ryan-james-thomas/digital-current-controller-circuit/Generated/Digital_Current_Servo_v3.pdf

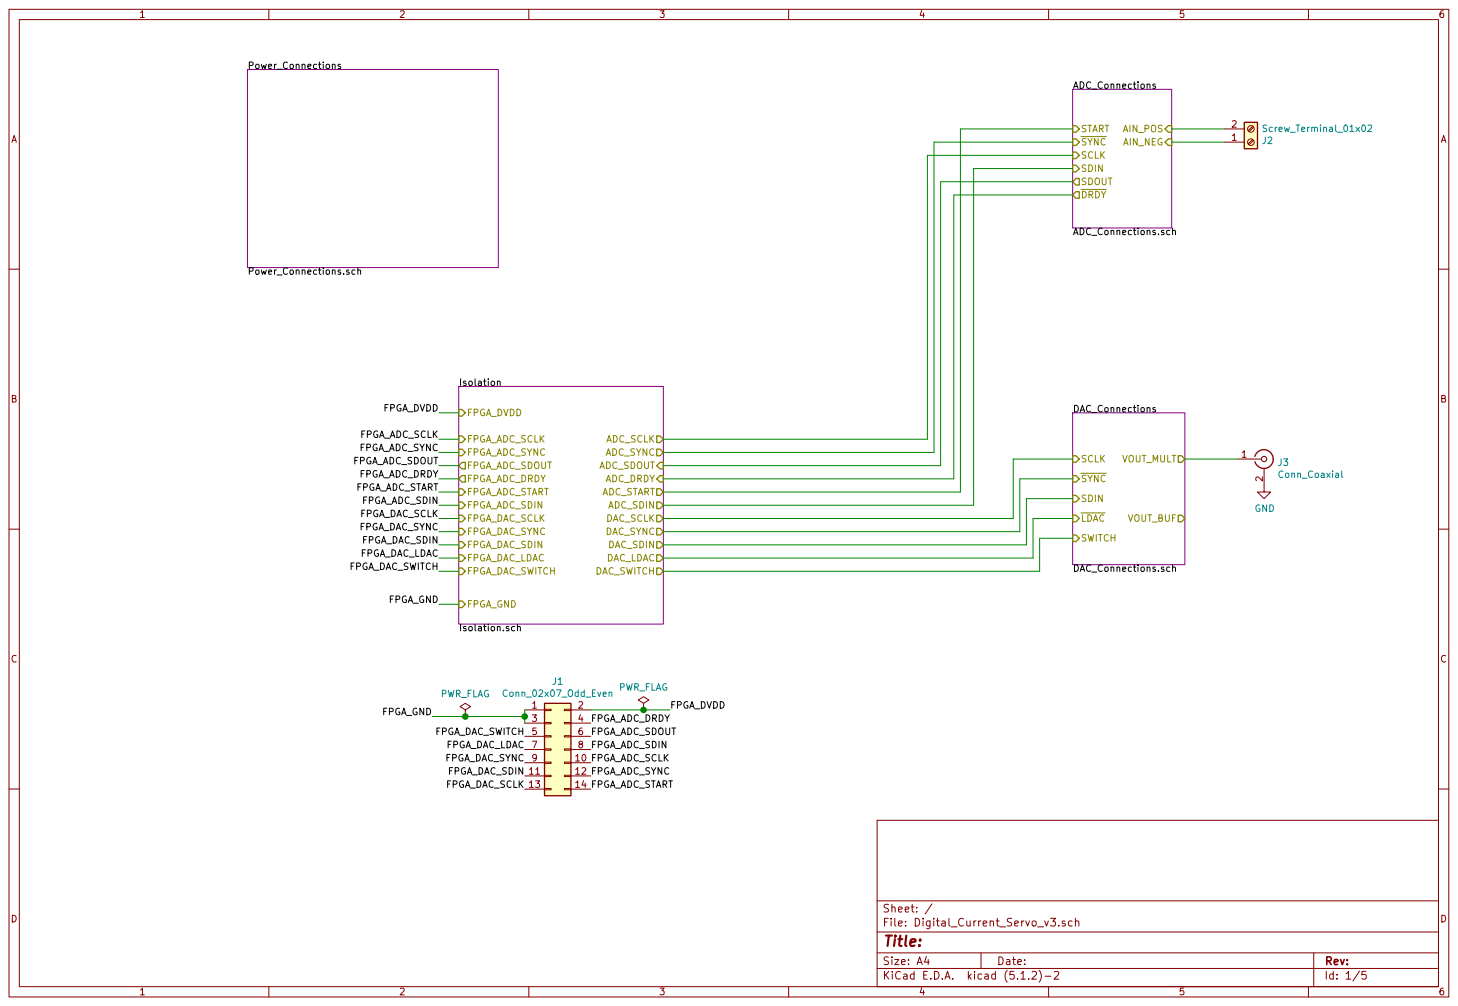
[picture p1: page 1]

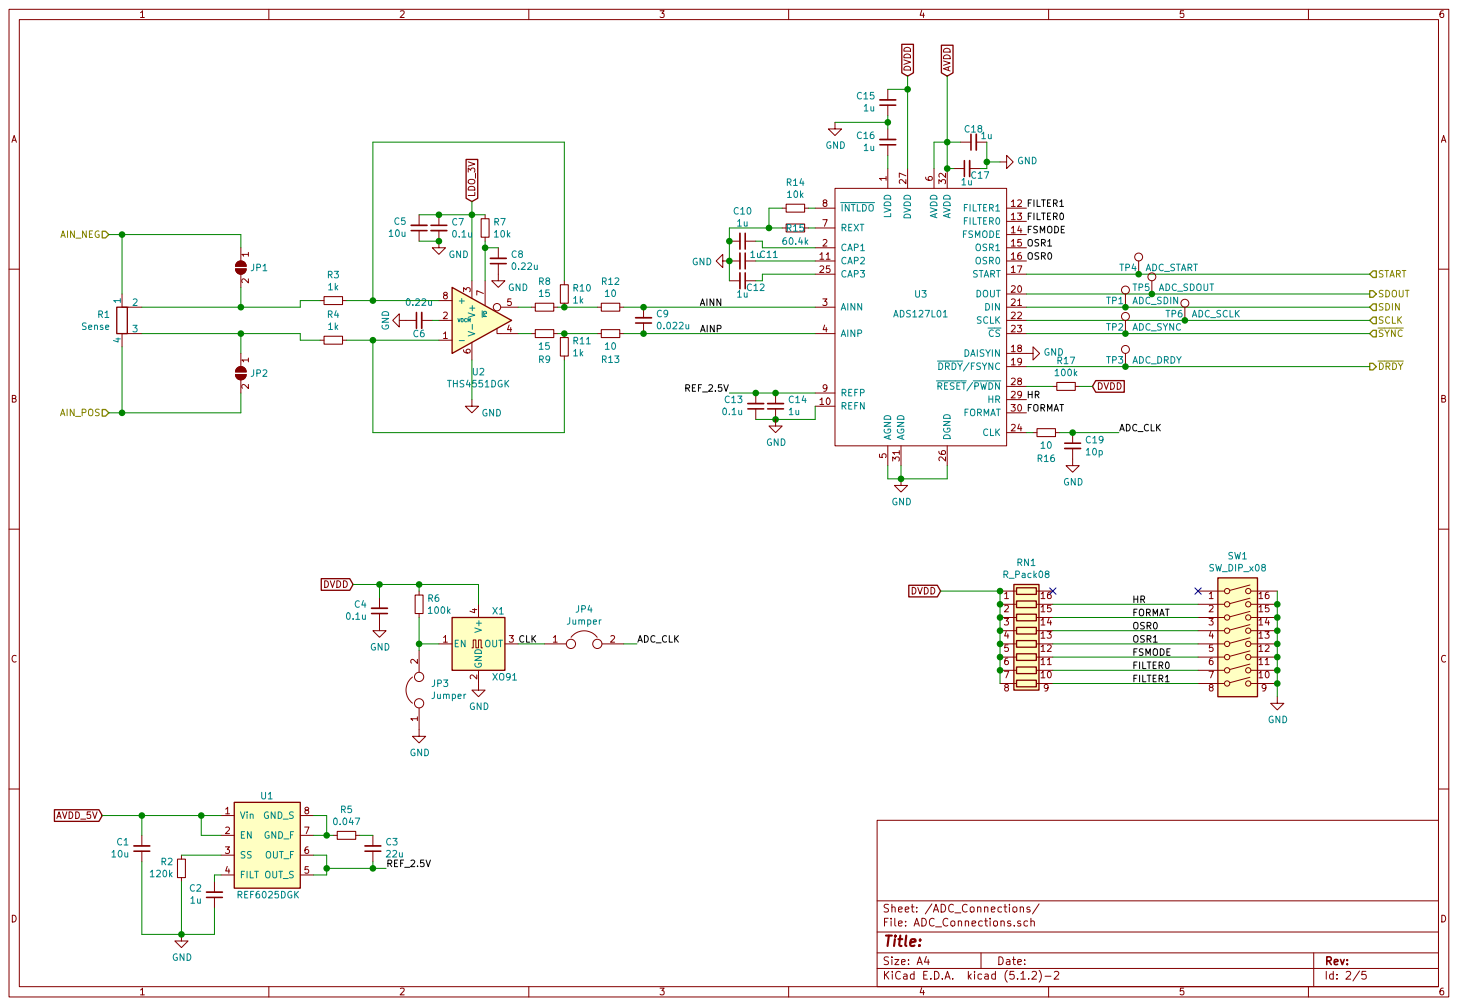
[picture p2: page 2]

1 REFN 10 CAP2 11 FILTER1 12 FILTER0 13 FSMODE 14 OSR1 15 OSR0 16 START 17 DAISYIN 18 DRDY/FSYNC 19 CAP1 2 DOUT 20 DIN 21 SCLK 22 CS 23 CLK 24 CAP3 25 DGND 26 DVDD 27 RESET/PWDN 28 HR 29 AINN 3 FORMAT 30 AGND 31 AVDD 32 AINP 4 AGND

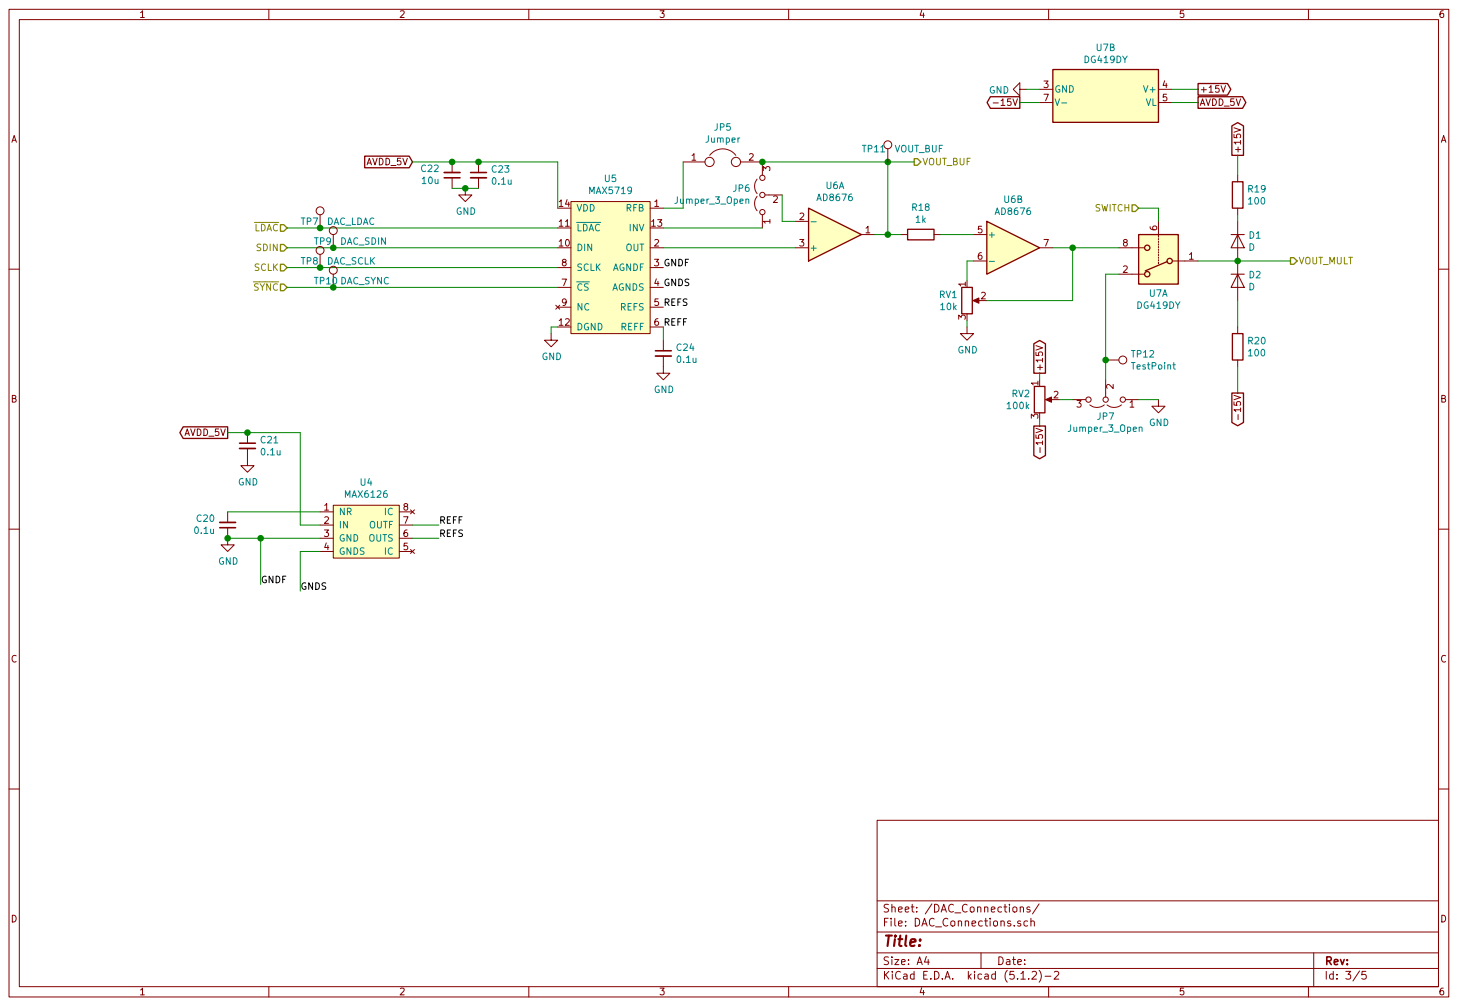
[picture p3: page 3]

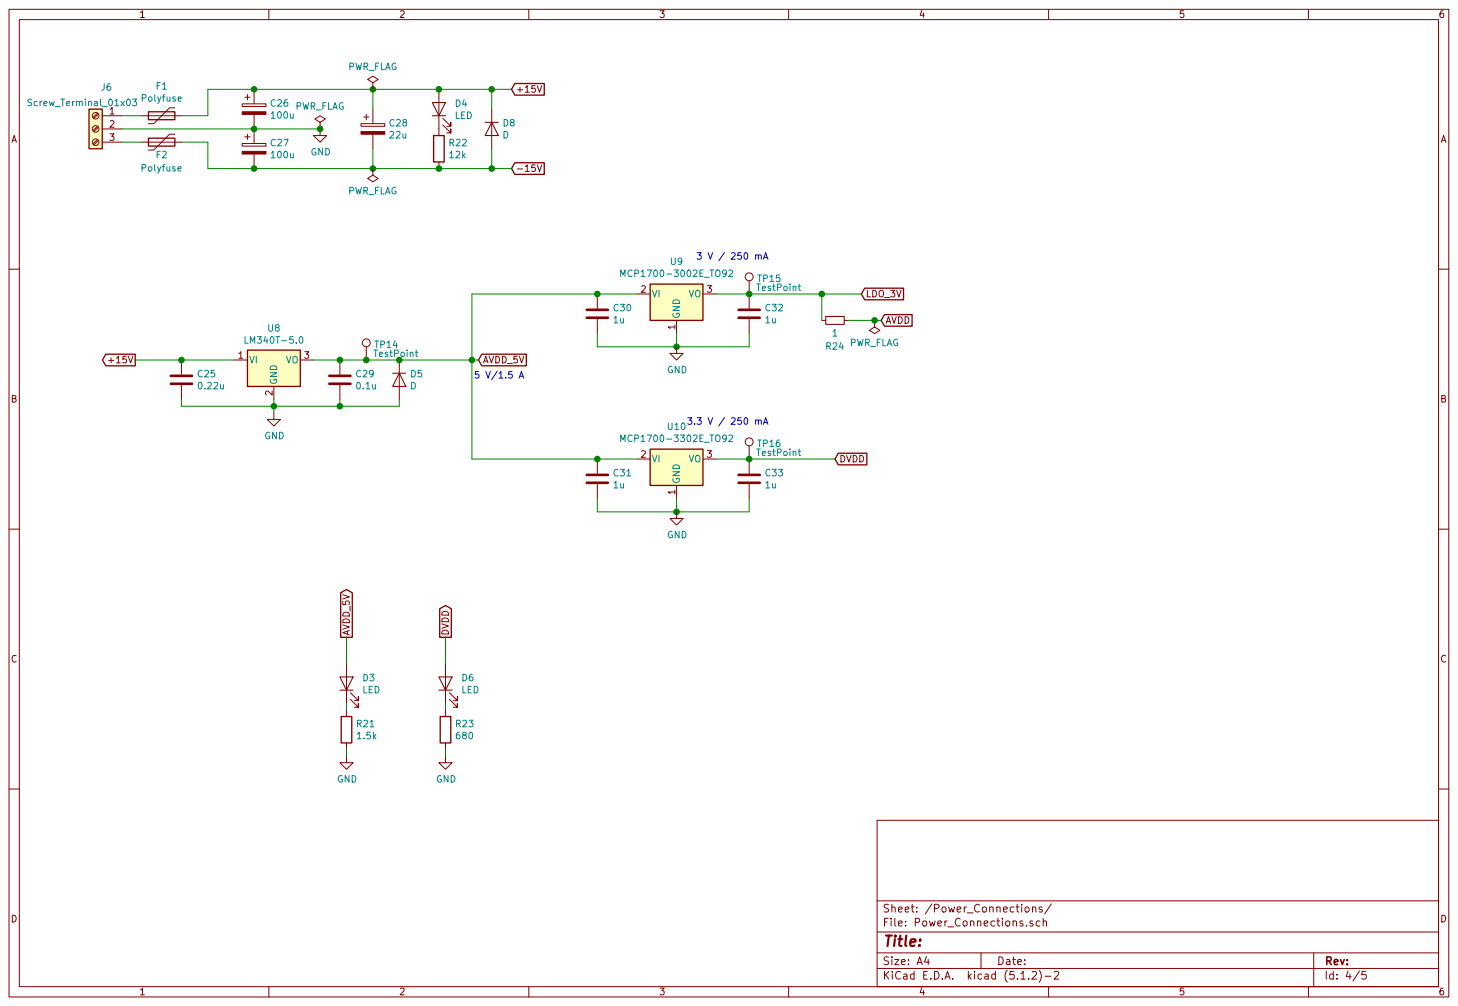
[picture p4: page 4]

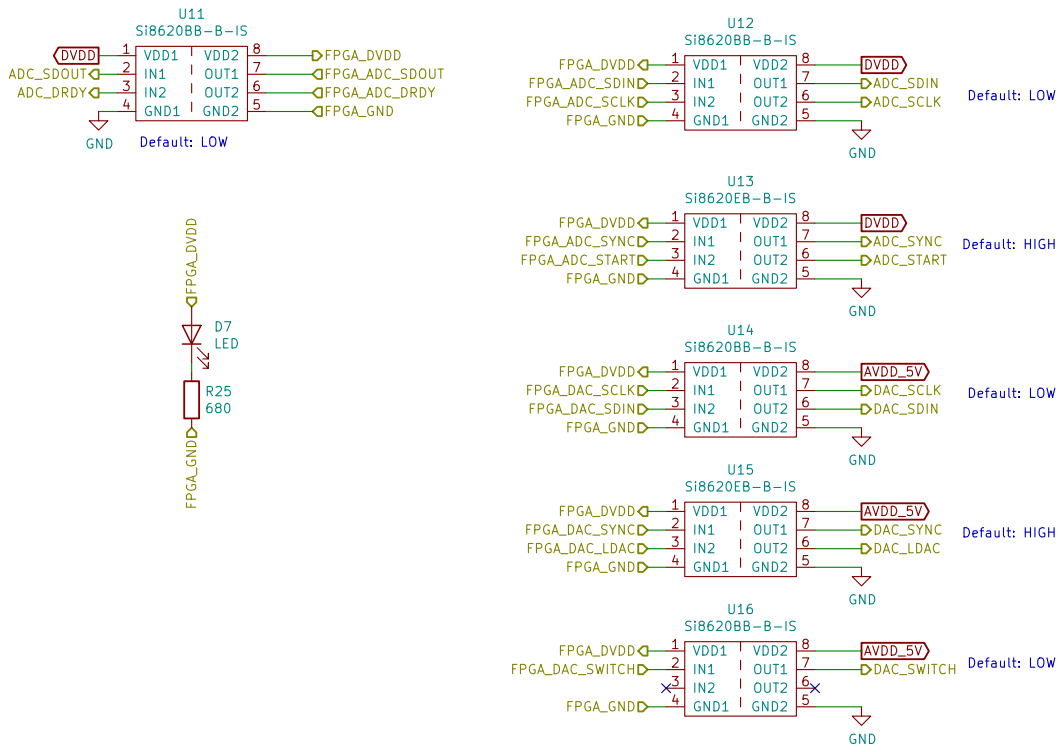
[picture p5: page 5]

Id: 5/5 Title: File: Isolation.sch Sheet: /Isolation/
