ryan-james-thomas/digital-current-controller-circuit/Digital_Current_Servo_v3.kicad_pcb

## KiCad design Digital_Current_Servo_v3.kicad_pcb (2023-01-15)

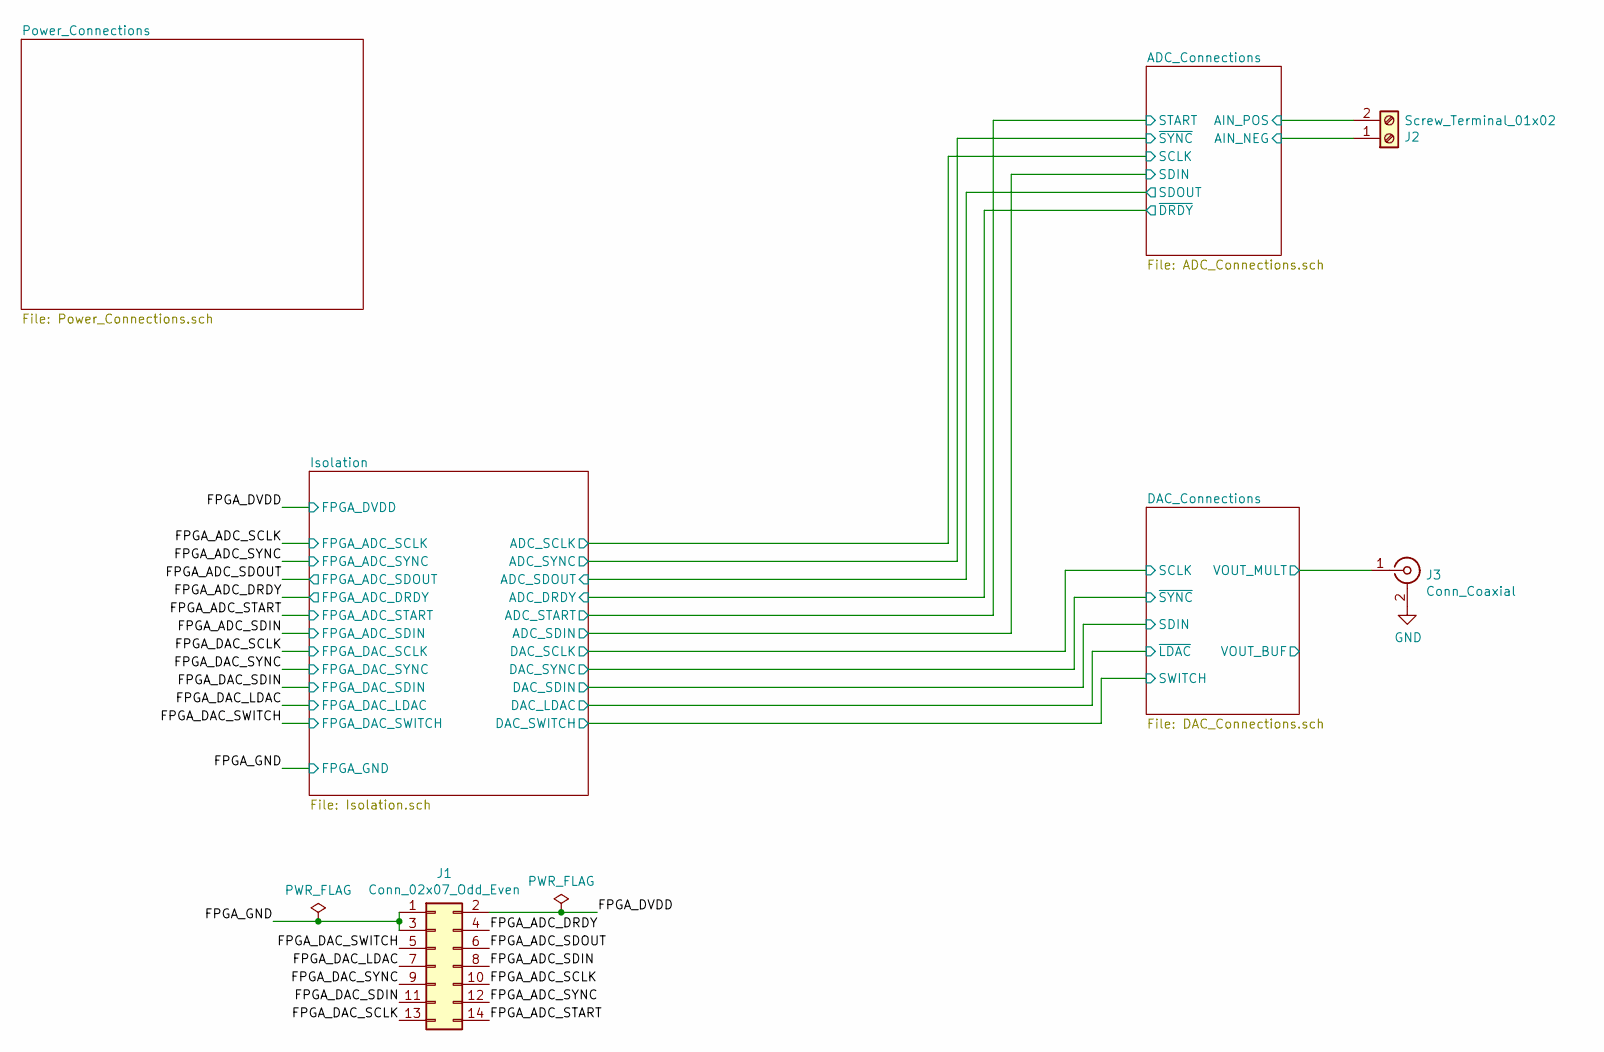
[picture p6: schematic Digital_Current_Servo_v3.sch]

Parts:
J1: Conn_02x07_Odd_Even; PinHeader_2x07_P2.54mm_Vertical; Digikey Part Number S2012EC-07-ND
J2: Screw_Terminal_01x02; TerminalBlock_bornier-2_P5.08mm; Digikey Part Number 732-10955-ND
J3: Conn_Coaxial; BNC_Amphenol_B6252HB-NPP3G-50_Horizontal; Digikey Part Number WM5514-ND

Connections:
/ADC_Connections/AIN_NEG: J2.1; also elsewhere on the board
/ADC_Connections/AIN_POS: J2.2; also elsewhere on the board
/DAC_Connections/VOUT_MULT: J3.1 (In); also elsewhere on the board
/FPGA_ADC_DRDY: J1.4; also elsewhere on the board
/FPGA_ADC_SCLK: J1.10; also elsewhere on the board
/FPGA_ADC_SDIN: J1.8; also elsewhere on the board
/FPGA_ADC_SDOUT: J1.6; also elsewhere on the board
/FPGA_ADC_START: J1.14; also elsewhere on the board
/FPGA_ADC_SYNC: J1.12; also elsewhere on the board
/FPGA_DAC_LDAC: J1.7; also elsewhere on the board
/FPGA_DAC_SCLK: J1.13; also elsewhere on the board
/FPGA_DAC_SDIN: J1.11; also elsewhere on the board
/FPGA_DAC_SWITCH: J1.5; also elsewhere on the board
/FPGA_DAC_SYNC: J1.9; also elsewhere on the board
/FPGA_DVDD: J1.2; also elsewhere on the board
/FPGA_GND: J1.1, J1.3; also elsewhere on the board
GND: J3.2 (Ext); also elsewhere on the board

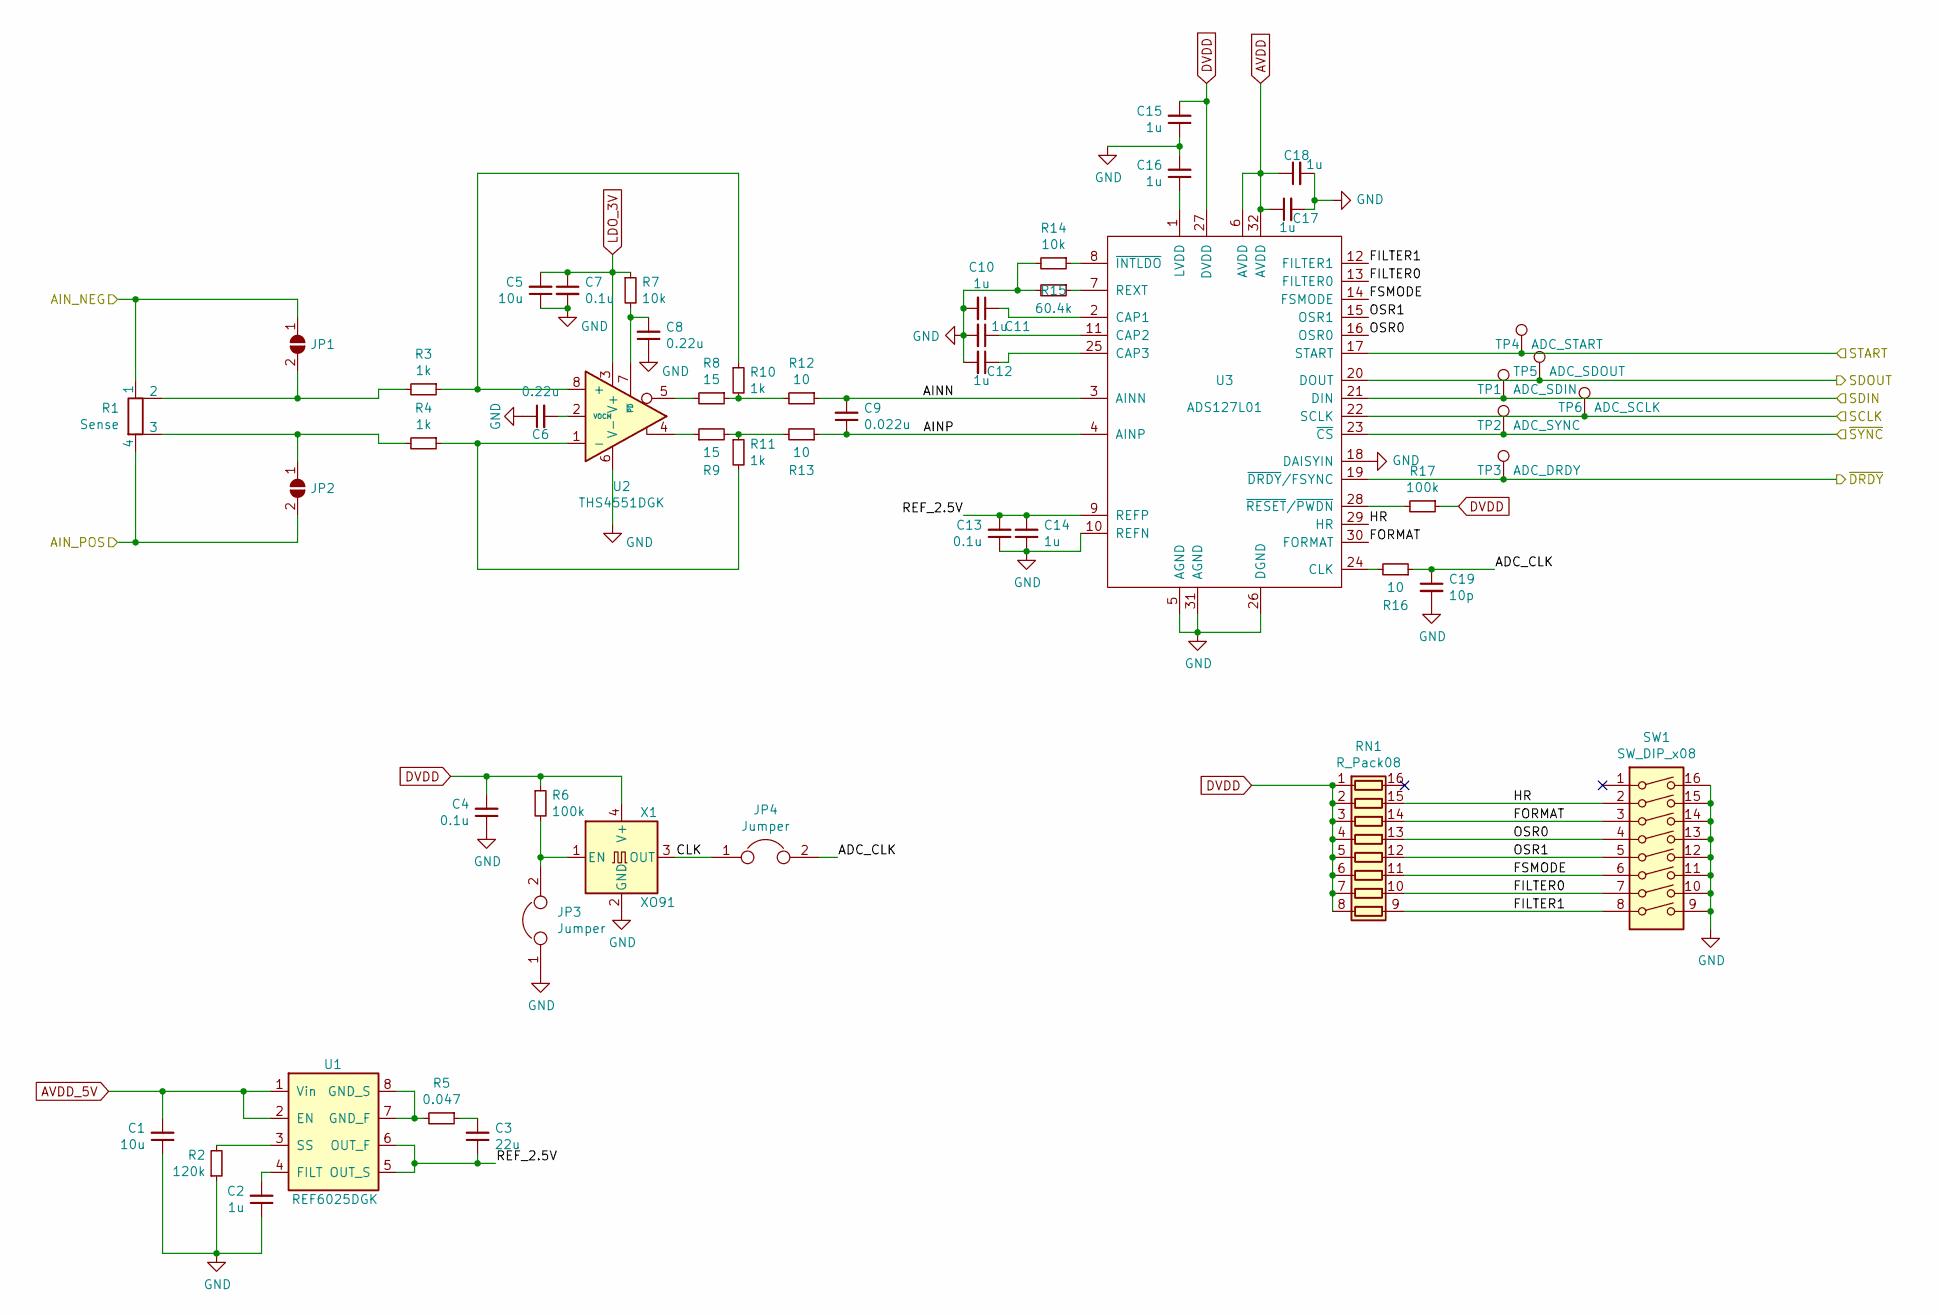
[picture p7: schematic ADC_Connections.sch]

Parts:
C1, C5: 10u; C_0805_2012Metric_Pad1.15x1.40mm_HandSolder; Digikey Part Number 1276-1052-1-ND
C2, C10, C11, C12, C14, C15, C16, C17, C18: 1u; C_0805_2012Metric_Pad1.15x1.40mm_HandSolder; Digikey Part Number 1276-6471-1-ND
C3: 22u; C_1206_3216Metric_Pad1.42x1.75mm_HandSolder; Digikey Part Number 1276-1771-1-ND
C4, C7, C13: 0.1u; C_0805_2012Metric_Pad1.15x1.40mm_HandSolder; Digikey Part Number 1276-1003-1-ND
C6, C8: 0.22u; C_0805_2012Metric_Pad1.15x1.40mm_HandSolder; Digikey Part Number 1276-6478-1-ND
C9: 0.022u; C_0805_2012Metric_Pad1.15x1.40mm_HandSolder; Digikey Part Number 399-1163-1-ND
C19: 10p; C_0805_2012Metric_Pad1.15x1.40mm_HandSolder; Digikey Part Number 1276-1109-1-ND
JP1, JP2: SolderJumper_2_Open; SolderJumper-2_P1.3mm_Open_Pad1.0x1.5mm
JP3, JP4: Jumper; PinHeader_1x02_P2.54mm_Vertical; Digikey Part Number S1012EC-02-ND
R1: Sense; TO-220-4_Vertical; Digikey Part Number Y1690-10A-ND
R2: 120k; R_0805_2012Metric_Pad1.15x1.40mm_HandSolder; Digikey Part Number RR12P120KDCT-ND
R3, R4, R10, R11: 1k; R_0805_2012Metric_Pad1.15x1.40mm_HandSolder; Digikey Part Number P1.0KDACT-ND
R5: 0.047; R_0805_2012Metric_Pad1.15x1.40mm_HandSolder; Digikey Part Number 1276-6158-1-ND
R6, R17: 100k; R_0805_2012Metric_Pad1.15x1.40mm_HandSolder; Digikey Part Number 1276-3512-1-ND‎
R7, R14: 10k; R_0805_2012Metric_Pad1.15x1.40mm_HandSolder; Digikey Part Number ‎P10.0KCCT-ND‎
R8, R9: 15; R_0805_2012Metric_Pad1.15x1.40mm_HandSolder; Digikey Part Number YAG4833CT-ND
R12, R13, R16: 10; R_0805_2012Metric_Pad1.15x1.40mm_HandSolder; Digikey Part Number A119971CT-ND
R15: 60.4k; R_0805_2012Metric_Pad1.15x1.40mm_HandSolder; Digikey Part Number RR12P60.4KDCT-ND
RN1: R_Pack08; SOIC-16_W4.9_P1.27; Digikey Part Number 4816P-T01-104LF-ND
SW1: SW_DIP_x08; SOIC-16_W8.6mm_P2.54mm; Digikey Part Number CT2198LPST-ND
TP1: ADC_SDIN; TestPoint_Pad_1.0x1.0mm
TP2: ADC_SYNC; TestPoint_Pad_1.0x1.0mm
TP3: ADC_DRDY; TestPoint_Pad_1.0x1.0mm
TP4: ADC_START; TestPoint_Pad_1.0x1.0mm
TP5: ADC_SDOUT; TestPoint_Pad_1.0x1.0mm
TP6: ADC_SCLK; TestPoint_Pad_1.0x1.0mm
U1: REF6025DGK; VSSOP-8_3.0x3.0mm_P0.65mm; Digikey Part Number 296-51527-1-ND
U2: THS4551DGK; VSSOP-8_3.0x3.0mm_P0.65mm; Digikey Part Number 296-47312-1-ND
U3: ADS127L01; LQFP-32_5x5mm_P0.5mm; Digikey Part Number 296-44344-1-ND
X1: XO91; Oscillator_SMD_Abracon_ASE-4Pin_3.2x2.5mm_HandSoldering; Digikey Part Number 535-11459-1-ND

Connections:
/ADC_Connections/ADC_CLK: C19.1, JP4.2, R16.1
/ADC_Connections/AINN: C9.2, R12.1, U3.3 (AINN)
/ADC_Connections/AINP: C9.1, R13.1, U3.4 (AINP)
/ADC_Connections/AIN_NEG: JP1.1 (A), R1.1; also elsewhere on the board
/ADC_Connections/AIN_POS: JP2.2 (B), R1.4; also elsewhere on the board
/ADC_Connections/CLK: JP4.1, X1.3 (OUT)
/ADC_Connections/FILTER0: RN1.10 (R7.2), SW1.7, U3.13 (FILTER0)
/ADC_Connections/FILTER1: RN1.9 (R8.2), SW1.8, U3.12 (FILTER1)
/ADC_Connections/FORMAT: RN1.14 (R3.2), SW1.3, U3.30 (FORMAT)
/ADC_Connections/FSMODE: RN1.11 (R6.2), SW1.6, U3.14 (FSMODE)
/ADC_Connections/HR: RN1.15 (R2.2), SW1.2, U3.29 (HR)
/ADC_Connections/OSR0: RN1.13 (R4.2), SW1.4, U3.16 (OSR0)
/ADC_Connections/OSR1: RN1.12 (R5.2), SW1.5, U3.15 (OSR1)
/ADC_Connections/REF_2.5V: C3.1, C13.2, C14.2, U1.5 (OUT_S), U1.6 (OUT_F), U3.9 (REFP)
/Isolation/ADC_DRDY: TP3.1, U3.19 (~DRDY~/FSYNC); also elsewhere on the board
/Isolation/ADC_SCLK: TP6.1, U3.22 (SCLK); also elsewhere on the board
/Isolation/ADC_SDIN: TP1.1, U3.21 (DIN); also elsewhere on the board
/Isolation/ADC_SDOUT: TP5.1, U3.20 (DOUT); also elsewhere on the board
/Isolation/ADC_START: TP4.1, U3.17 (START); also elsewhere on the board
/Isolation/ADC_SYNC: TP2.1, U3.23 (~CS); also elsewhere on the board
AVDD: C17.1, C18.1, U3.6 (AVDD), U3.32 (AVDD); also elsewhere on the board
AVDD_5V: C1.2, U1.1 (Vin), U1.2 (EN); also elsewhere on the board
DVDD: C4.2, C15.2, R6.1, R17.1, RN1.1 (R1.1), RN1.2 (R2.1), RN1.3 (R3.1), RN1.4 (R4.1), RN1.5 (R5.1), RN1.6 (R6.1), RN1.7 (R7.1), RN1.8 (R8.1), U3.27 (DVDD), X1.4 (V+); also elsewhere on the board
GND: C1.1, C2.1, C4.1, C5.1, C6.1, C7.2, C8.1, C10.2, C11.2, C12.2, C13.1, C14.1, C15.1, C16.2, C17.2, C18.2, C19.2, JP3.1, R2.1, R14.2, R15.2, SW1.9, SW1.10, SW1.11, SW1.12, SW1.13, SW1.14, SW1.15, SW1.16, U2.6 (V-), U3.5 (AGND), U3.10 (REFN), U3.18 (DAISYIN), U3.26 (DGND), U3.31 (AGND), X1.2 (GND); also elsewhere on the board
LDO_3V: C5.2, C7.1, R7.1, U2.3 (V+); also elsewhere on the board
unnamed: C2.2, U1.4 (FILT)
unnamed: C3.2, R5.1
unnamed: C6.2, U2.2 (VOCM)
unnamed: C8.2, R7.2, U2.7 (~PD)
unnamed: C10.1, U3.2 (CAP1)
unnamed: C11.1, U3.11 (CAP2)
unnamed: C12.1, U3.25 (CAP3)
unnamed: C16.1, U3.1 (LVDD)
unnamed: JP1.2 (B), R1.2, R3.2
unnamed: JP2.1 (A), R1.3, R4.2
unnamed: JP3.2, R6.2, X1.1 (EN)
unnamed: R2.2, U1.3 (SS)
unnamed: R5.2, U1.7 (GND_F), U1.8 (GND_S)
unnamed: R8.2, U2.5
unnamed: R9.1, U2.4
unnamed: R3.1, R10.1, U2.8 (+)
unnamed: R8.1, R10.2, R12.2
unnamed: R9.2, R11.1, R13.2
unnamed: R4.1, R11.2, U2.1 (-)
unnamed: R14.1, U3.8 (~INTLDO)
unnamed: R15.1, U3.7 (REXT)
unnamed: R16.2, U3.24 (CLK)
unnamed: R17.2, U3.28 (~RESET~/~PWDN)

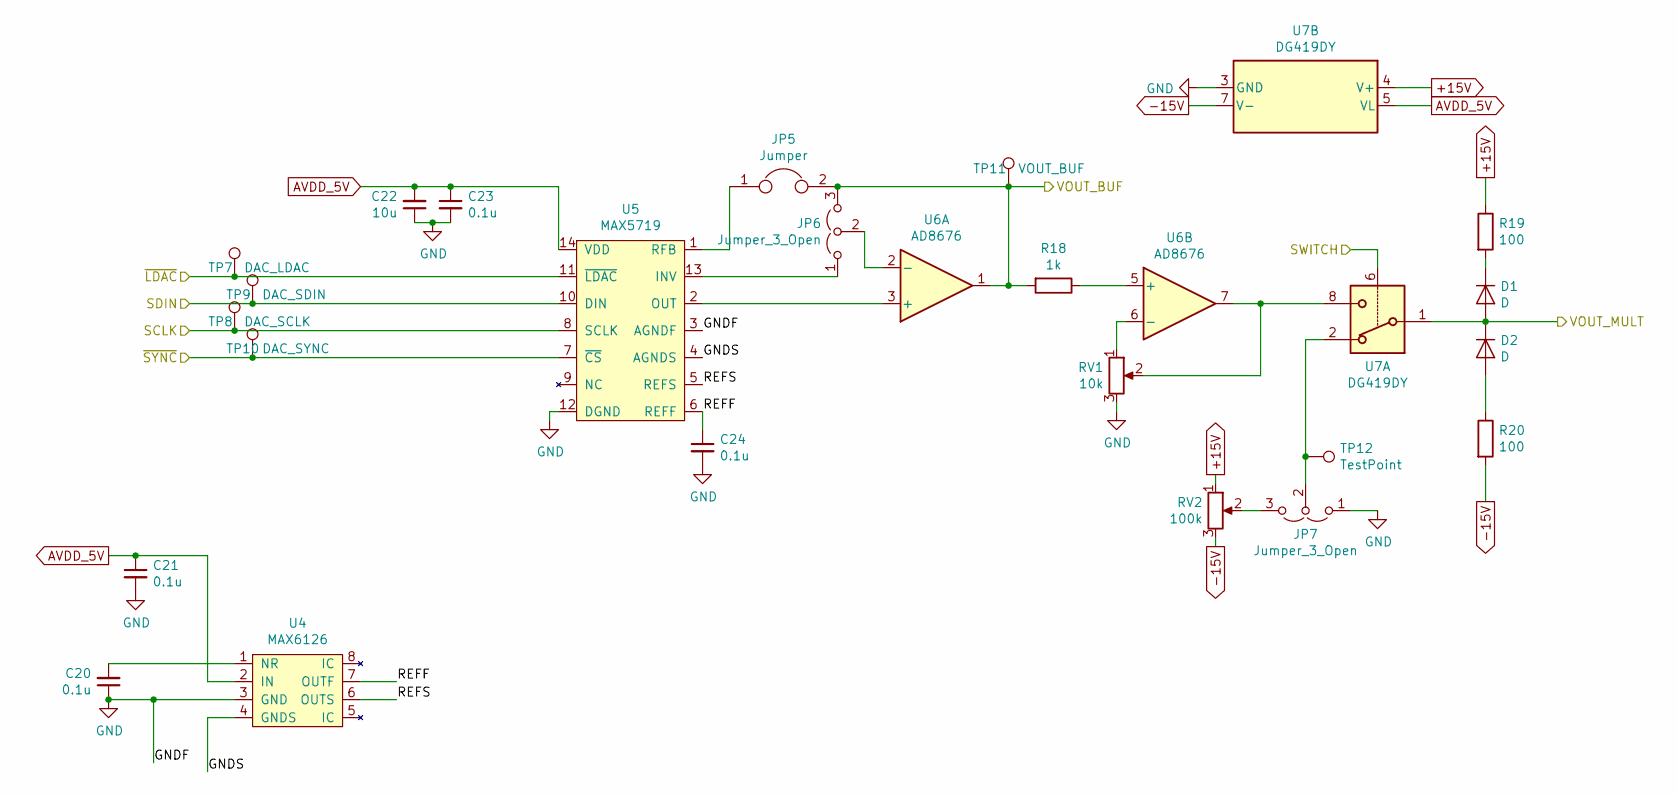
[picture p8: schematic DAC_Connections.sch]

Parts:
C20, C21, C23, C24: 0.1u; C_0805_2012Metric_Pad1.15x1.40mm_HandSolder; Digikey Part Number 1276-1003-1-ND
C22: 10u; C_0805_2012Metric_Pad1.15x1.40mm_HandSolder; Digikey Part Number 1276-1052-1-ND
D1, D2: D; D_DO-41_SOD81_P7.62mm_Horizontal; Digikey Part Number 1N4007-TPMSCT-ND
JP5: Jumper; PinHeader_1x02_P2.54mm_Vertical; Digikey Part Number S1012EC-02-ND
JP6, JP7: Jumper_3_Open; PinHeader_1x03_P2.54mm_Vertical; Digikey Part Number S1012EC-03-ND
R18: 1k; R_0805_2012Metric_Pad1.15x1.40mm_HandSolder; Digikey Part Number P1.0KDACT-ND
R19, R20: 100; R_Axial_DIN0207_L6.3mm_D2.5mm_P7.62mm_Horizontal; Digikey Part Number CF14JT100RCT-ND
RV1: 10k; Potentiometer_Bourns_3296W_Vertical; Digikey Part Number 490-2875-ND
RV2: 100k; Potentiometer_Bourns_3296W_Vertical; Digikey Part Number 490-2876-ND
TP7: DAC_LDAC; TestPoint_Pad_1.0x1.0mm
TP8: DAC_SCLK; TestPoint_Pad_1.0x1.0mm
TP9: DAC_SDIN; TestPoint_Pad_1.0x1.0mm
TP10: DAC_SYNC; TestPoint_Pad_1.0x1.0mm
TP11: VOUT_BUF; TestPoint_Pad_1.0x1.0mm
TP12: TestPoint; TestPoint_Pad_1.0x1.0mm
U4: MAX6126; SOIC-8_3.9x4.9mm_P1.27mm; Digikey Part Number MAX6126BASA41+-ND
U5: MAX5719; SOIC-14_3.9x8.7mm_P1.27mm; Digikey Part Number MAX5719GSD+-ND
U6: AD8676; SOIC-8_3.9x4.9mm_P1.27mm; Digikey Part Number AD8676ARZ-ND
U7: DG419DY; SOIC-8_3.9x4.9mm_P1.27mm; Digikey Part Number DG419DY-T1-E3CT-ND

Connections:
+15V: R19.1, RV2.1, U7.4 (V+); also elsewhere on the board
-15V: R20.2, RV2.3, U7.7 (V-); also elsewhere on the board
/DAC_Connections/GNDS: U4.4 (GNDS), U5.4 (AGNDS)
/DAC_Connections/REFF: C24.1, U4.7 (OUTF), U5.6 (REFF)
/DAC_Connections/REFS: U4.6 (OUTS), U5.5 (REFS)
/DAC_Connections/VOUT_BUF: JP5.2, JP6.3 (B), R18.2, TP11.1, U6.1
/DAC_Connections/VOUT_MULT: D1.2 (A), D2.1 (K), U7.1; also elsewhere on the board
/Isolation/DAC_LDAC: TP7.1, U5.11 (~LDAC); also elsewhere on the board
/Isolation/DAC_SCLK: TP8.1, U5.8 (SCLK); also elsewhere on the board
/Isolation/DAC_SDIN: TP9.1, U5.10 (DIN); also elsewhere on the board
/Isolation/DAC_SWITCH: U7.6; also elsewhere on the board
/Isolation/DAC_SYNC: TP10.1, U5.7 (~CS); also elsewhere on the board
AVDD_5V: C21.1, C22.2, C23.1, U4.2 (IN), U5.14 (VDD), U7.5 (VL); also elsewhere on the board
GND: C20.1, C21.2, C22.1, C23.2, C24.2, JP7.1 (A), RV1.3, U4.3 (GND), U5.3 (AGNDF), U5.12 (DGND), U7.3 (GND); also elsewhere on the board
unnamed: C20.2, U4.1 (NR)
unnamed: D1.1 (K), R19.2
unnamed: D2.2 (A), R20.1
unnamed: JP5.1, U5.1 (RFB)
unnamed: JP6.1 (A), U5.13 (INV)
unnamed: JP6.2 (C), U6.2 (-)
unnamed: JP7.2 (C), TP12.1, U7.2
unnamed: JP7.3 (B), RV2.2
unnamed: R18.1, U6.5 (+)
unnamed: RV1.1, U6.6 (-)
unnamed: RV1.2, U6.7, U7.8
unnamed: U5.2 (OUT), U6.3 (+)

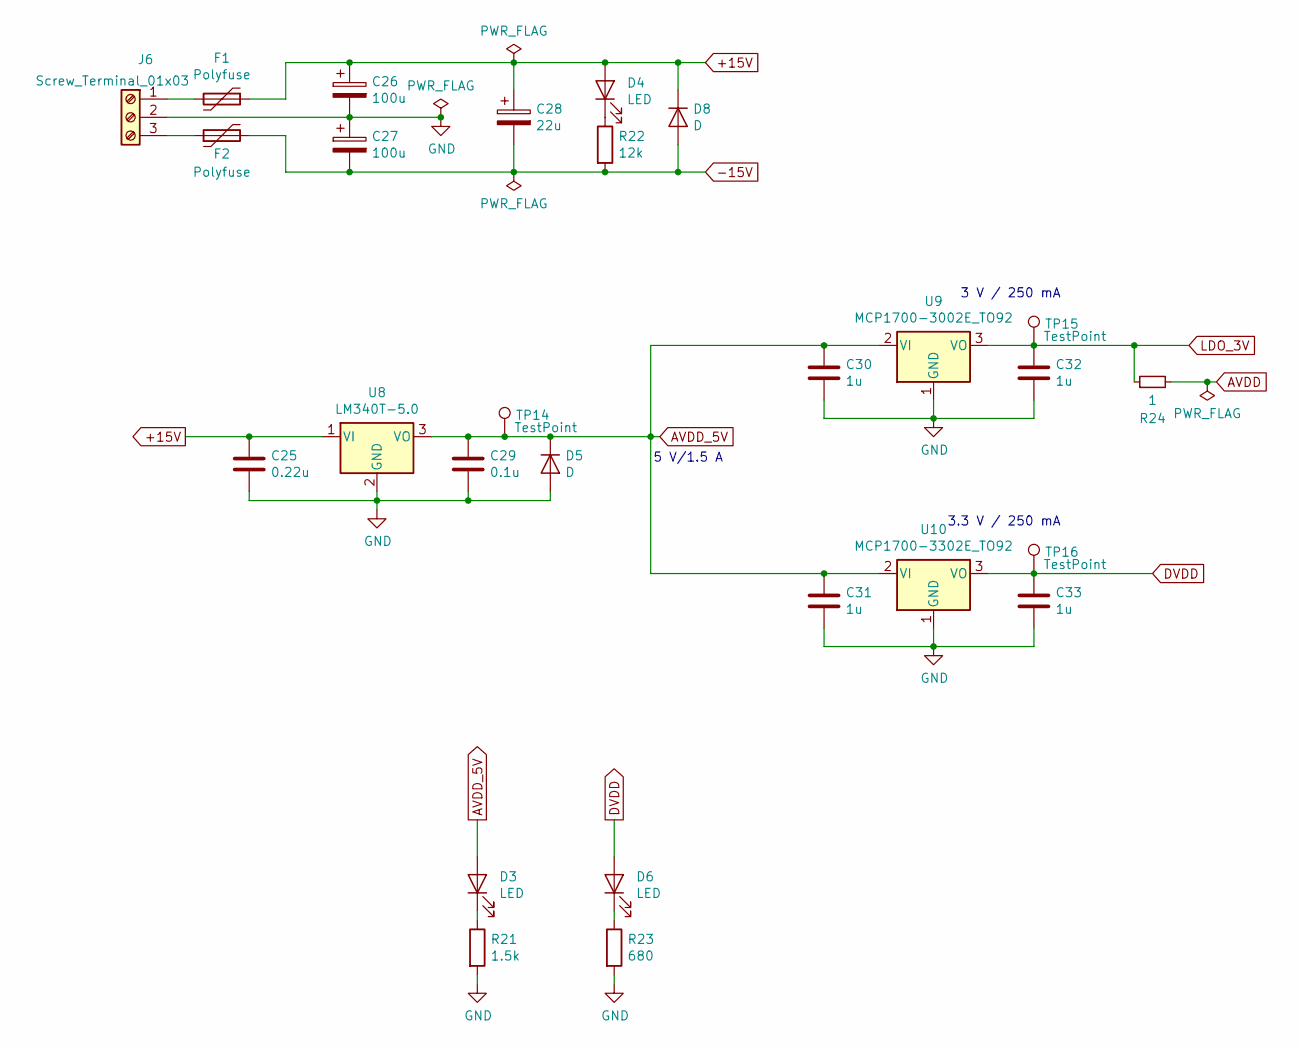
[picture p9: schematic Power_Connections.sch]

Parts:
C25: 0.22u; C_0805_2012Metric_Pad1.15x1.40mm_HandSolder; Digikey Part Number 1276-6478-1-ND
C26, C27: 100u; CP_Radial_D8.0mm_P3.50mm; Digikey Part Number 732-8666-1-ND
C28: 22u; CP_Radial_D5.0mm_P2.00mm; Digikey Part Number 732-8662-1-ND
C29: 0.1u; C_0805_2012Metric_Pad1.15x1.40mm_HandSolder; Digikey Part Number 1276-1003-1-ND
C30, C31, C32, C33: 1u; C_0805_2012Metric_Pad1.15x1.40mm_HandSolder; Digikey Part Number 1276-6471-1-ND
D3, D6: LED; LED_0805_2012Metric_Pad1.15x1.40mm_HandSolder; Digikey Part Number 754-2043-1-ND
D4: LED; LED_D5.0mm; Digikey Part Number 732-5020-ND
D5, D8: D; D_DO-41_SOD81_P7.62mm_Horizontal; Digikey Part Number 1N4007-TPMSCT-ND
F1, F2: Polyfuse; Fuse_1206_3216Metric_Pad1.42x1.75mm_HandSolder; Digikey Part Number 507-1803-1-ND
J6: Screw_Terminal_01x03; TerminalBlock_bornier-3_P5.08mm; Digikey Part Number 732-10956-ND
R21: 1.5k; R_0805_2012Metric_Pad1.15x1.40mm_HandSolder; Digikey Part Number RHM1.5KKCT-ND
R22: 12k; R_0805_2012Metric_Pad1.15x1.40mm_HandSolder; Digikey Part Number A126337CT-ND
R23: 680; R_0805_2012Metric_Pad1.15x1.40mm_HandSolder; Digikey Part Number A129747CT-ND
R24: 1; R_0805_2012Metric_Pad1.15x1.40mm_HandSolder; Digikey Part Number CSR0805FK1R00CT-ND
TP14, TP15, TP16: TestPoint; TestPoint_Pad_1.0x1.0mm
U8: LM340T-5.0; TO-220-3_Vertical; Digikey Part Number LM340T-5.0/NOPB-ND
U9: MCP1700-3002E_TO92; TO-92_Inline; Digikey Part Number MCP1700-3002E/TO-ND
U10: MCP1700-3302E_TO92; TO-92_Inline; Digikey Part Number MCP1700-3302E/TO-ND

Connections:
+15V: C25.1, C26.1, C28.1, D4.2 (A), D8.1 (K), F1.1, U8.1 (VI); also elsewhere on the board
-15V: C27.2, C28.2, D8.2 (A), F2.2, R22.2; also elsewhere on the board
AVDD: R24.2; also elsewhere on the board
AVDD_5V: C29.1, C30.1, C31.1, D3.2 (A), D5.1 (K), TP14.1, U8.3 (VO), U9.2 (VI), U10.2 (VI); also elsewhere on the board
DVDD: C33.1, D6.2 (A), TP16.1, U10.3 (VO); also elsewhere on the board
GND: C25.2, C26.2, C27.1, C29.2, C30.2, C31.2, C32.2, C33.2, D5.2 (A), J6.2, R21.2, R23.2, U8.2 (GND), U9.1 (GND), U10.1 (GND); also elsewhere on the board
LDO_3V: C32.1, R24.1, TP15.1, U9.3 (VO); also elsewhere on the board
unnamed: D3.1 (K), R21.1
unnamed: D4.1 (K), R22.1
unnamed: D6.1 (K), R23.1
unnamed: F1.2, J6.1
unnamed: F2.1, J6.3

Notes on the sheet:
5 V/1.5 A
3 V / 250 mA
3.3 V / 250 mA

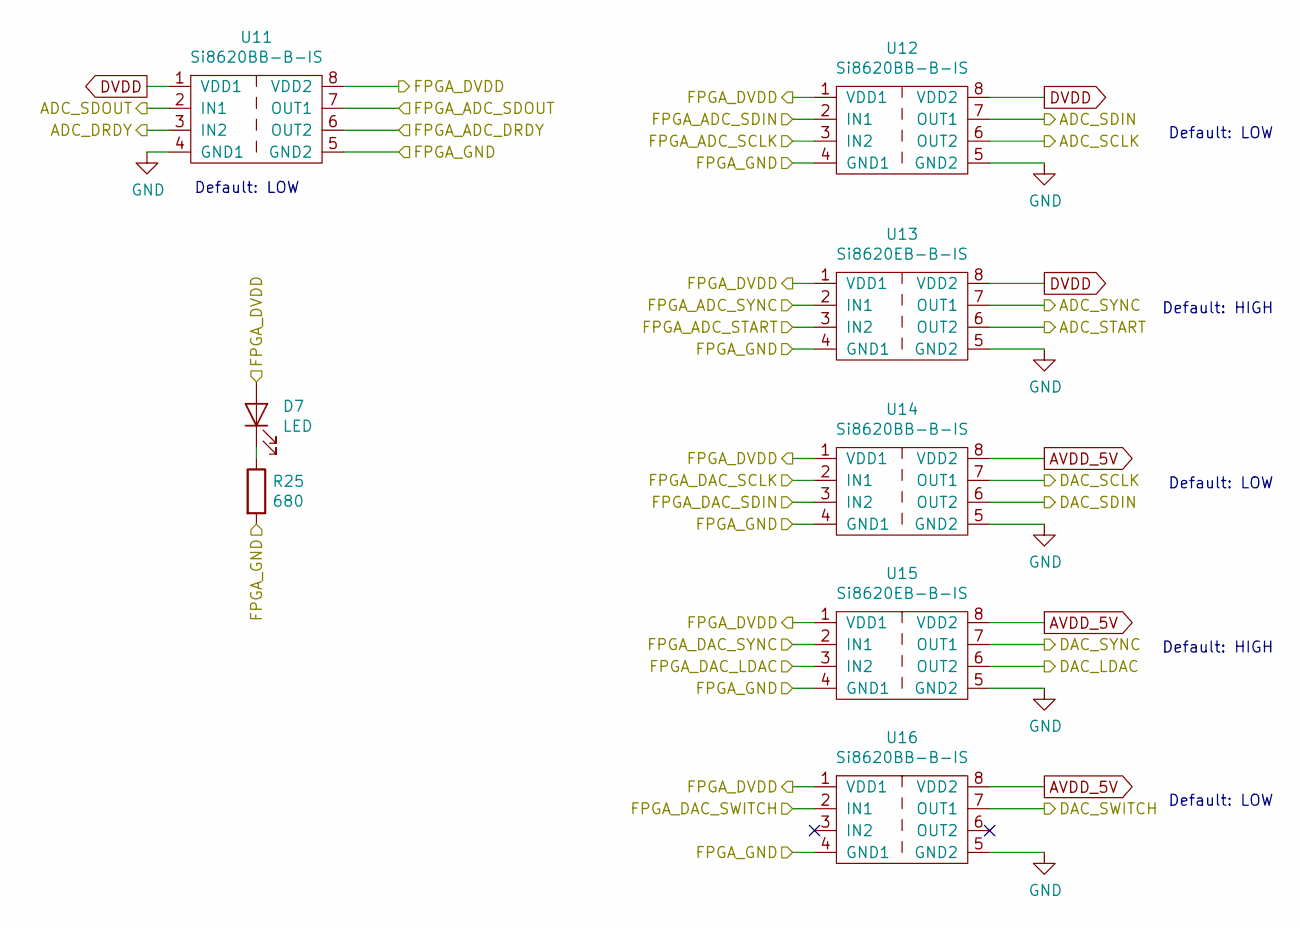
[picture p10: schematic Isolation.sch]

Parts:
D7: LED; LED_0805_2012Metric_Pad1.15x1.40mm_HandSolder; Digikey Part Number 754-2043-1-ND
R25: 680; R_0805_2012Metric_Pad1.15x1.40mm_HandSolder; Digikey Part Number A129747CT-ND
U11, U12, U14, U16: Si8620BB-B-IS; SOIC-8_3.9x4.9mm_P1.27mm; Digikey Part Number 336-4209-1-ND
U13, U15: Si8620EB-B-IS; SOIC-8_3.9x4.9mm_P1.27mm; Digikey Part Number SI8620EB-B-IS-ND

Connections:
/FPGA_ADC_DRDY: U11.6 (OUT2); also elsewhere on the board
/FPGA_ADC_SCLK: U12.3 (IN2); also elsewhere on the board
/FPGA_ADC_SDIN: U12.2 (IN1); also elsewhere on the board
/FPGA_ADC_SDOUT: U11.7 (OUT1); also elsewhere on the board
/FPGA_ADC_START: U13.3 (IN2); also elsewhere on the board
/FPGA_ADC_SYNC: U13.2 (IN1); also elsewhere on the board
/FPGA_DAC_LDAC: U15.3 (IN2); also elsewhere on the board
/FPGA_DAC_SCLK: U14.2 (IN1); also elsewhere on the board
/FPGA_DAC_SDIN: U14.3 (IN2); also elsewhere on the board
/FPGA_DAC_SWITCH: U16.2 (IN1); also elsewhere on the board
/FPGA_DAC_SYNC: U15.2 (IN1); also elsewhere on the board
/FPGA_DVDD: D7.2 (A), U11.8 (VDD2), U12.1 (VDD1), U13.1 (VDD1), U14.1 (VDD1), U15.1 (VDD1), U16.1 (VDD1); also elsewhere on the board
/FPGA_GND: R25.2, U11.5 (GND2), U12.4 (GND1), U13.4 (GND1), U14.4 (GND1), U15.4 (GND1), U16.4 (GND1); also elsewhere on the board
/Isolation/ADC_DRDY: U11.3 (IN2); also elsewhere on the board
/Isolation/ADC_SCLK: U12.6 (OUT2); also elsewhere on the board
/Isolation/ADC_SDIN: U12.7 (OUT1); also elsewhere on the board
/Isolation/ADC_SDOUT: U11.2 (IN1); also elsewhere on the board
/Isolation/ADC_START: U13.6 (OUT2); also elsewhere on the board
/Isolation/ADC_SYNC: U13.7 (OUT1); also elsewhere on the board
/Isolation/DAC_LDAC: U15.6 (OUT2); also elsewhere on the board
/Isolation/DAC_SCLK: U14.7 (OUT1); also elsewhere on the board
/Isolation/DAC_SDIN: U14.6 (OUT2); also elsewhere on the board
/Isolation/DAC_SWITCH: U16.7 (OUT1); also elsewhere on the board
/Isolation/DAC_SYNC: U15.7 (OUT1); also elsewhere on the board
AVDD_5V: U14.8 (VDD2), U15.8 (VDD2), U16.8 (VDD2); also elsewhere on the board
DVDD: U11.1 (VDD1), U12.8 (VDD2), U13.8 (VDD2); also elsewhere on the board
GND: U11.4 (GND1), U12.5 (GND2), U13.5 (GND2), U14.5 (GND2), U15.5 (GND2), U16.5 (GND2); also elsewhere on the board
unnamed: D7.1 (K), R25.1

Notes on the sheet:
Default: LOW
Default: HIGH

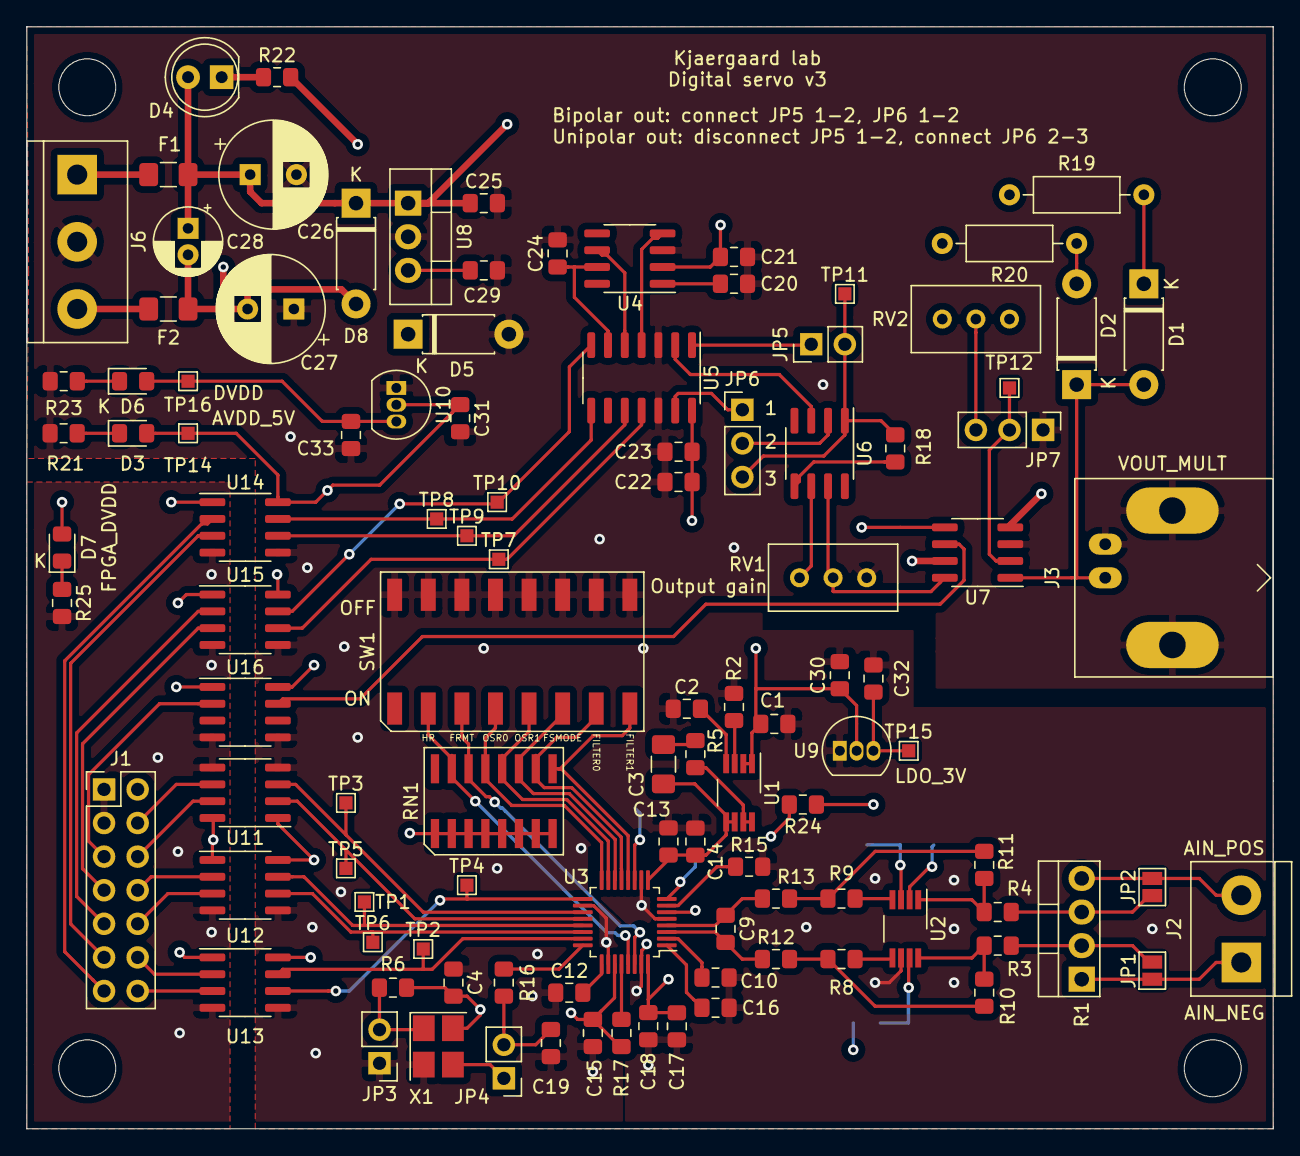
[picture p11: board Digital_Current_Servo_v3.kicad_pcb from above]

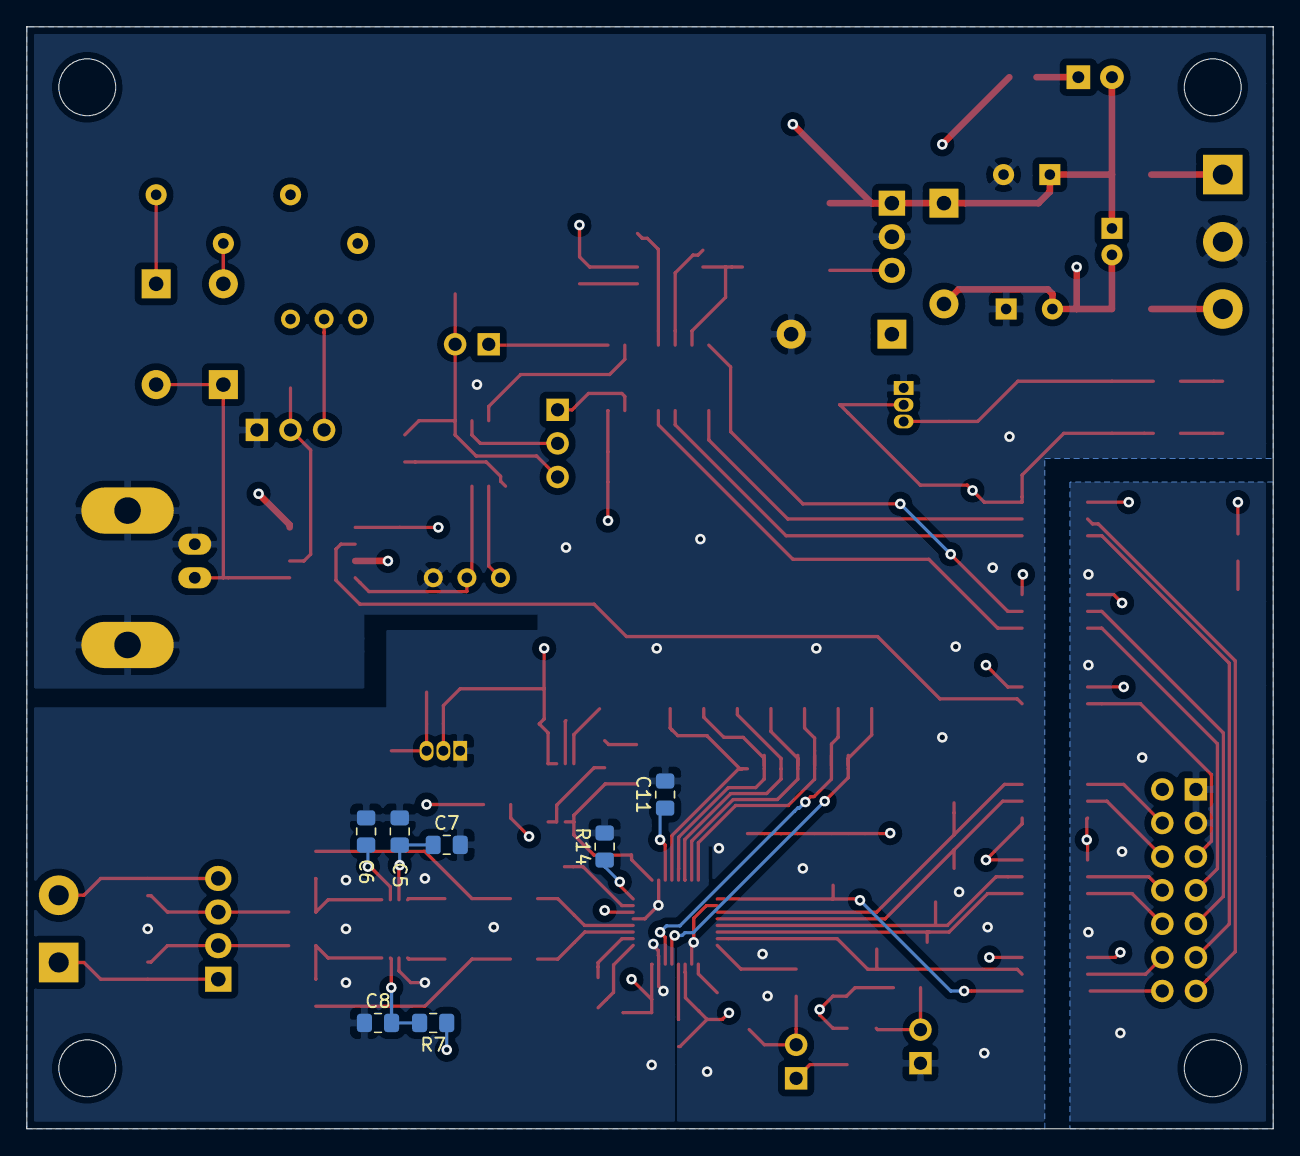
[picture p12: board Digital_Current_Servo_v3.kicad_pcb from below]

Board: 4 copper layers, 94.2 x 83.3 mm, 115 parts (7 on the bottom side), 91 nets.
